Pinoccio/hardware-backpack-wifi/README.md

wifi-hardware-reference
===========================

Contained are the schematics, board layout, data sheets, and BOM for the Pinoccio WiFi board.

The board revisions are also marked as tags in the git repository, if you'd like to see a previous version.
