Pinoccio/hardware-backpack-wifi/changes.txt

------------------------------------------------------------------------
- v1.0 - 2013-08-15
------------------------------------------------------------------------
- Rename some components for assembly

------------------------------------------------------------------------
- v0.13 - 2013-07-30
------------------------------------------------------------------------
- Add 100k pull-up resistor to general storage flash chip-select
- Add 100k pull-up resistors to both flash chips /H and /W pins
- Add programming pads for GS1011 external flash for faster programming
- Move backpack bus from ATtiny13A PB0 to PB1 to take advantage of 
  PB1's external interrupt (INT0) support, for smaller codebase

------------------------------------------------------------------------
- v0.11 - 2013-06-28
------------------------------------------------------------------------
- Remove 150mA LDO regulator for storage components, directly from VBAT
- Add second 2MB flash storage for WiFi module OTA update and SSL support
- Add SPI connections to WiFi module, for later higher-speed transfer
- Tie WiFi module GPIO27 to D6 for triggering WiFi update
- Add ATtiny13A for Backpack-bus support 

------------------------------------------------------------------------
- v0.9 - 2012-12-28
------------------------------------------------------------------------
- Add 500mA LDO regulator for Wi-Fi shield, directly from VBAT
- Add 150mA LDO regulator for storage components, directly from VBAT
- Add 2MB flash storage for logging
- Move hole cutout down to match changes in base board layout
- Update header legends to map to base board header changes
- Tie LDO enable pins to 3v3 header
- Add 10uF/low ESR and 0.1uF to handle large spikes in µSD slot

------------------------------------------------------------------------
- v0.7 - 2012-11-08
------------------------------------------------------------------------
- Add larger 22uF cap to power supply rail
- Update header legends to map to base board header changes

------------------------------------------------------------------------
- v0.6 - 2012-10-03
------------------------------------------------------------------------
Initial release
