Pinoccio/hardware-backpack-wifi/pdf/pinoccio-wifi-brd.pdf

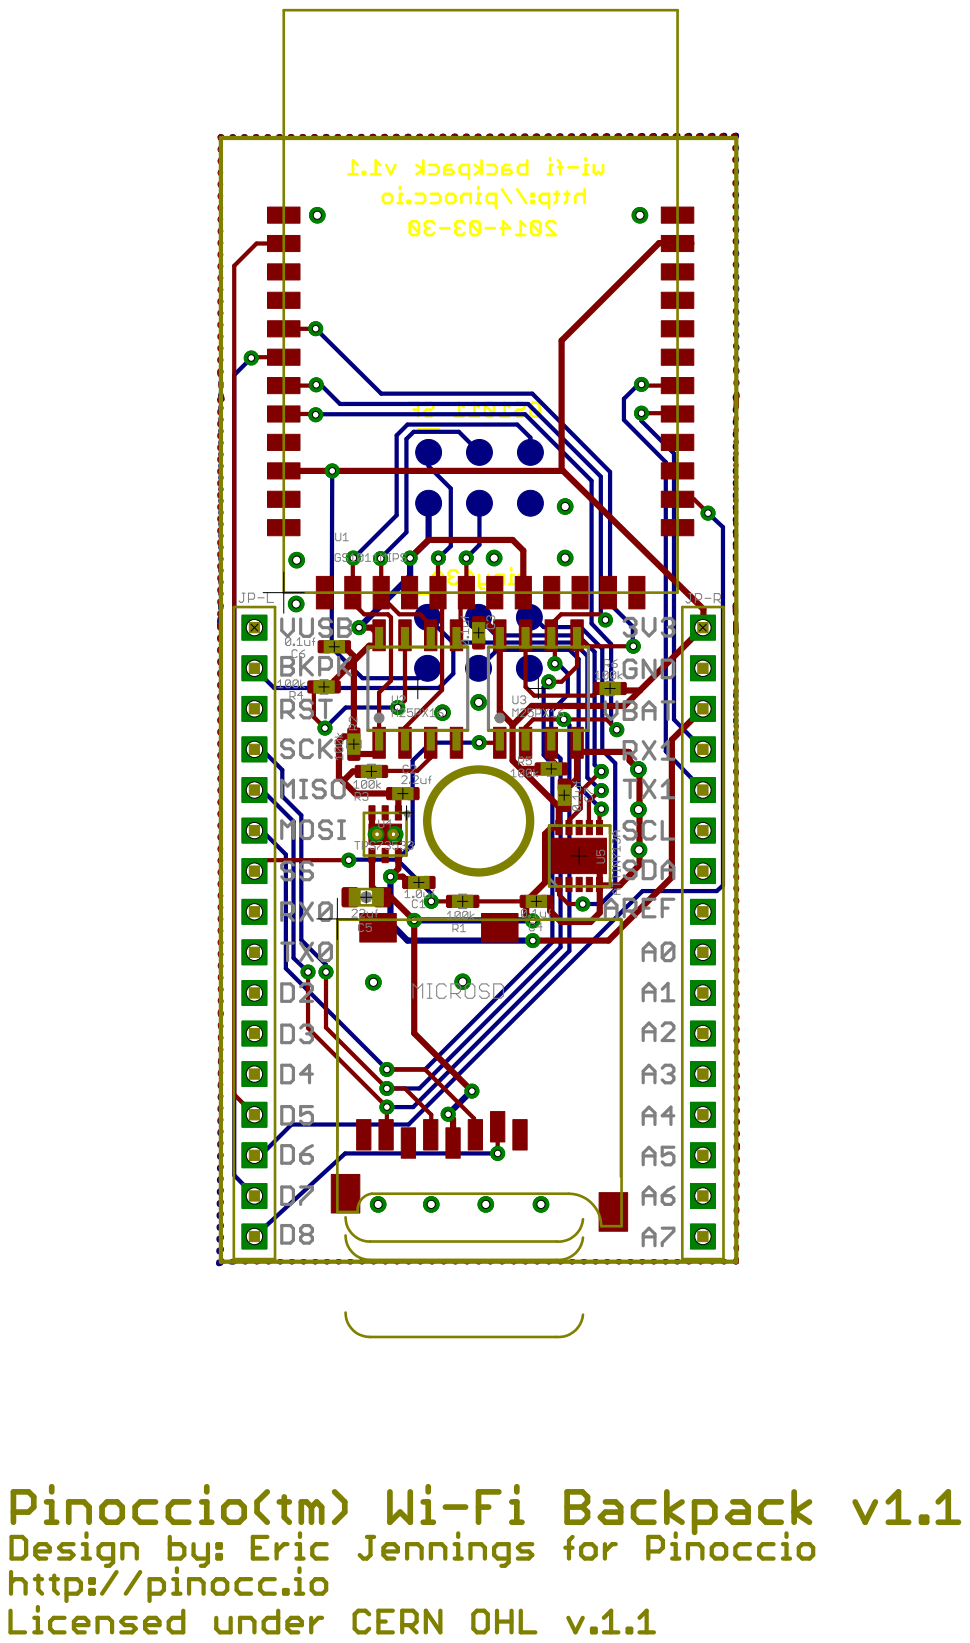
[picture p1: page 1]
