Pinoccio/hardware-backpack-wifi/pdf/pinoccio-wifi-sch.pdf

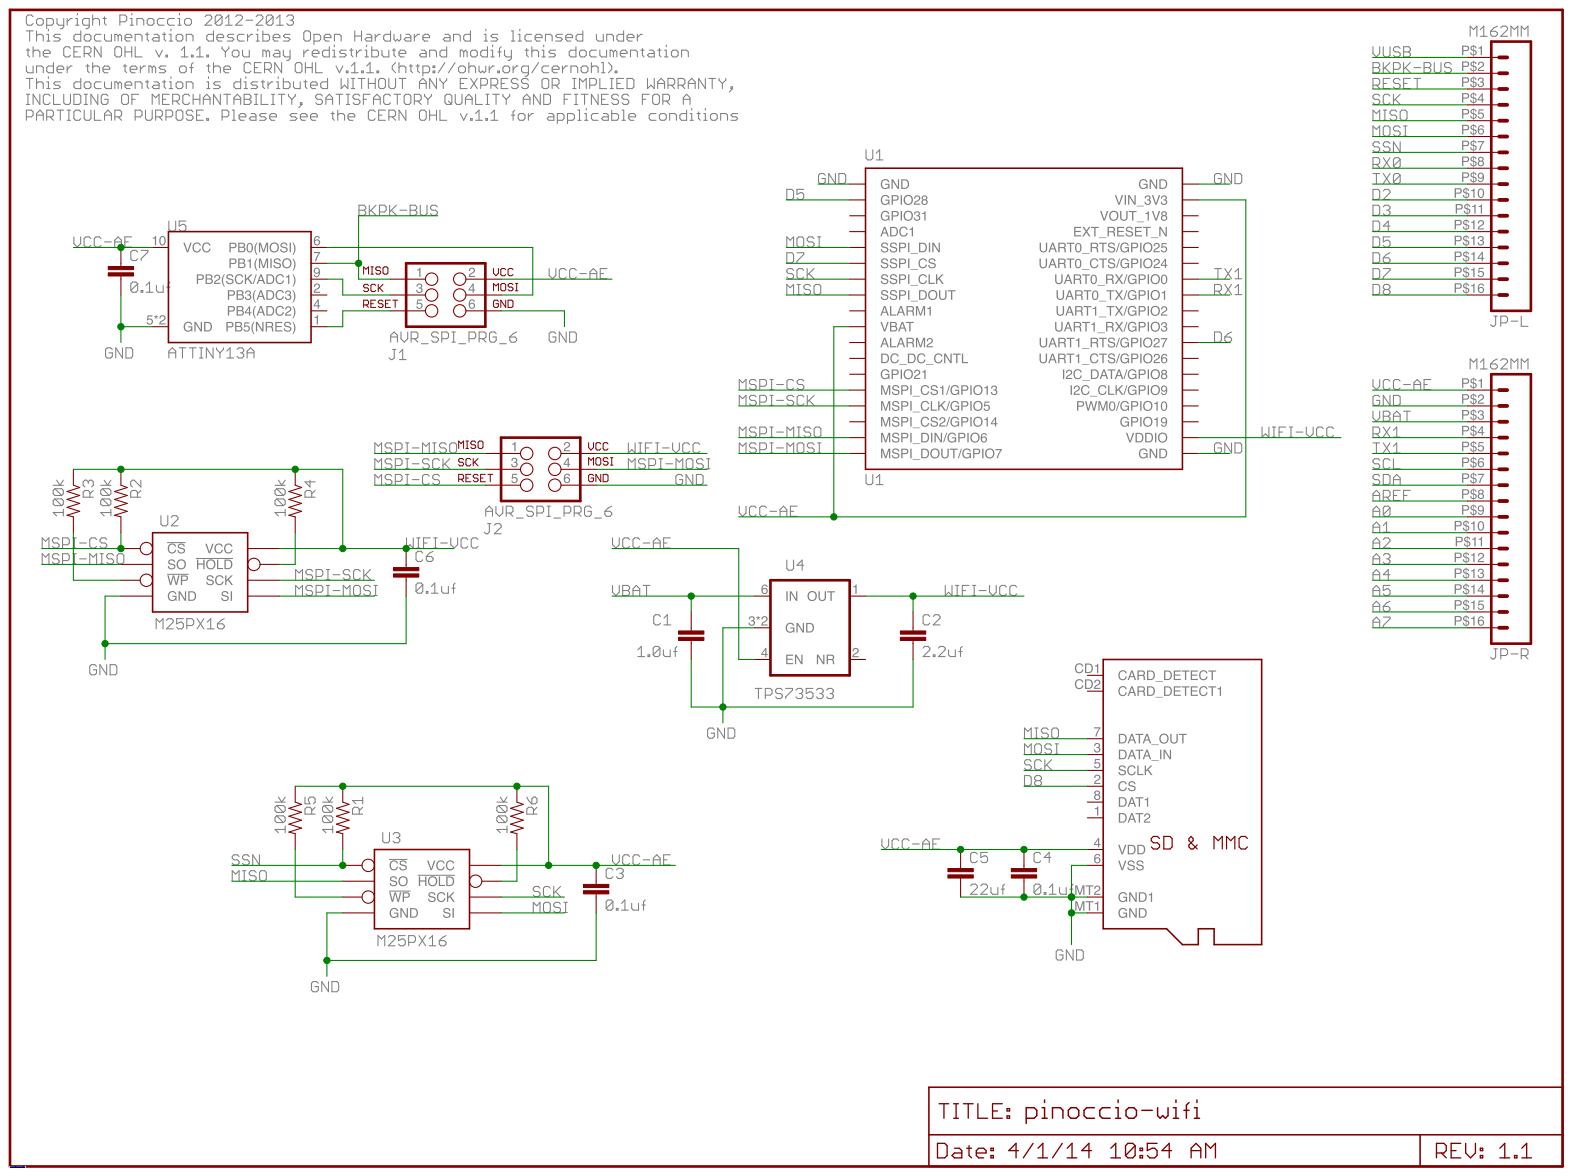
[picture p2: page 1]
