Pinoccio/hardware-backpack-wifi/pdf/v1.1/pinoccio-wifi-brd.pdf

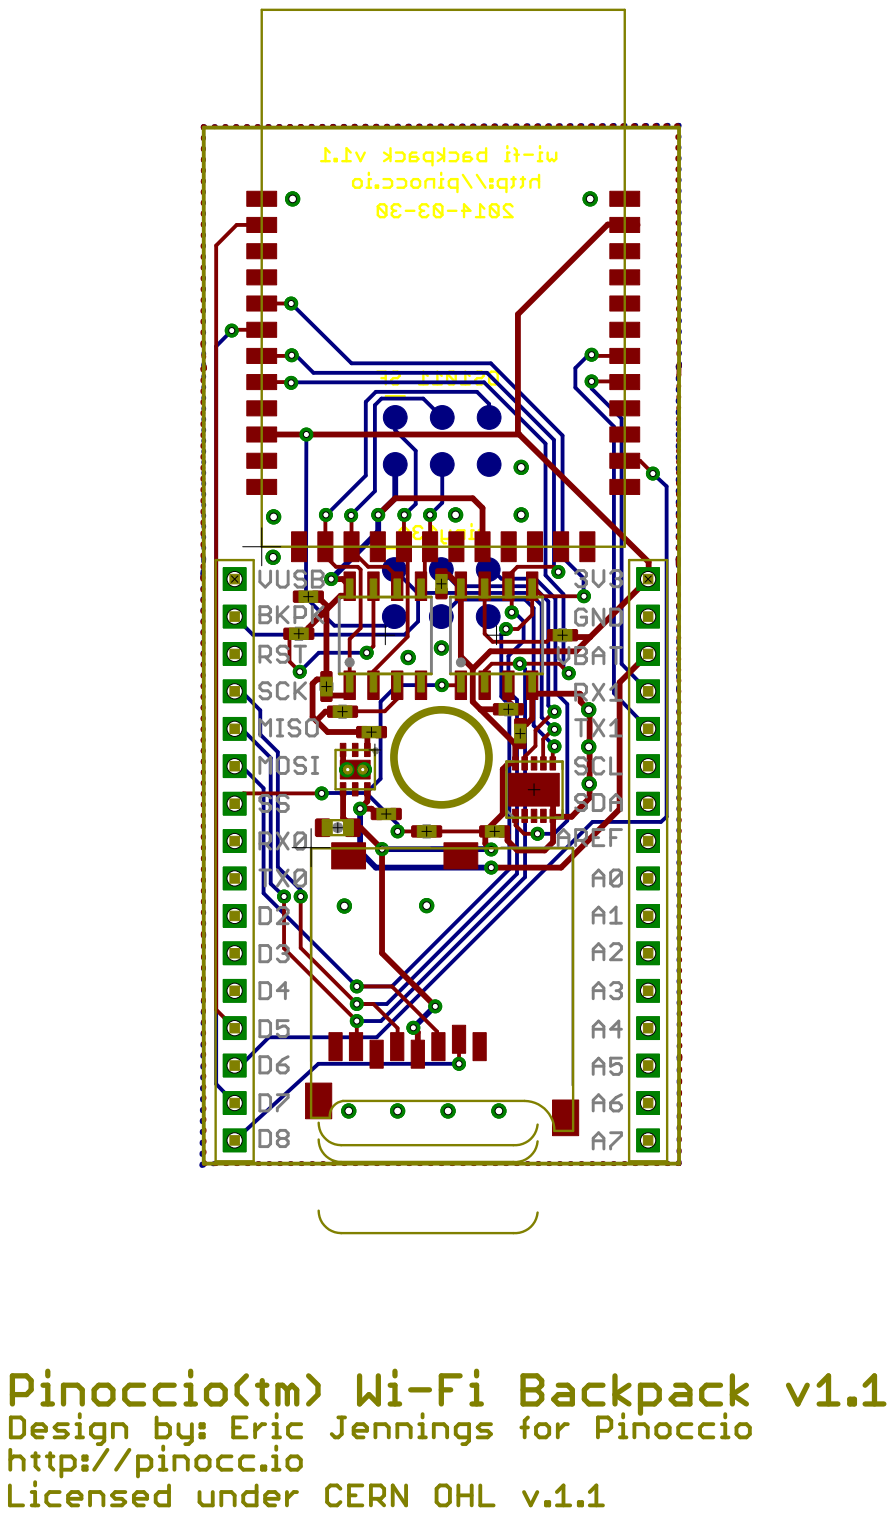
[picture p3: page 1]
