Pinoccio/hardware-backpack-wifi/eagle/pinoccio-wifi.brd

## EAGLE design eagle/pinoccio-wifi.brd (2014-06-27)

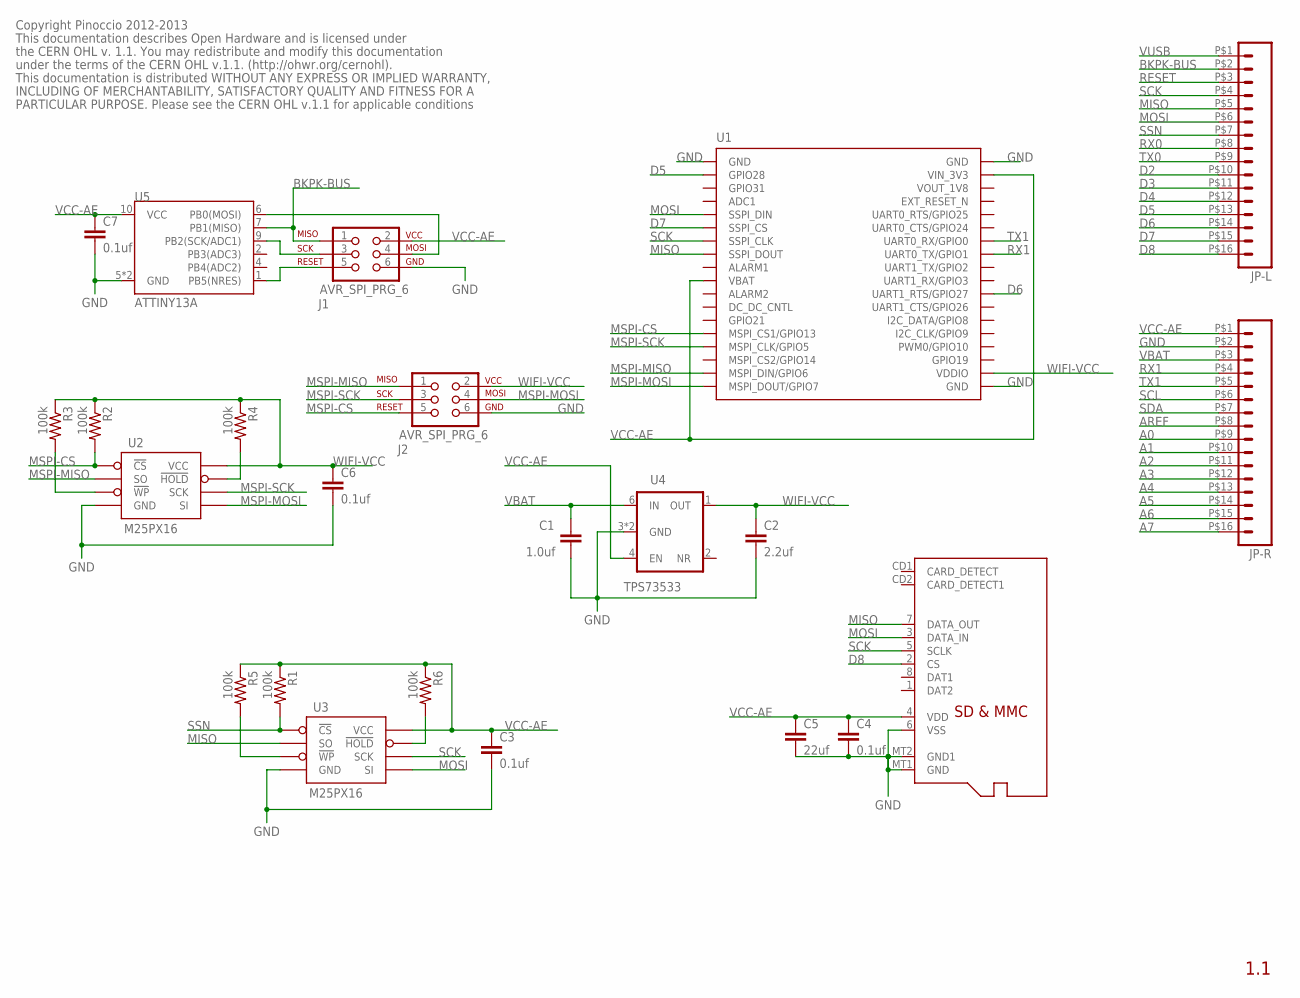
[picture p4: schematic pinoccio-wifi.sch]

Parts:
C1: 1.0uf; 0402-CAP
C2: 2.2uf; 0402-CAP
C3, C4, C6, C7: 0.1uf; 0402-CAP
C5: 22uf; 0603-CAP
J1, J2: AVR_SPI_PRG_6; 2X3-PAD
JP-L: M162MM; 1X16_2MM
JP-R: M162MM; 1X16_2MM
R1, R2, R3, R4, R5, R6: 100k; 0402-RES
U1: GS1011MIPS
U2, U3: M25PX16; SO8N
U4: TPS73533; SON-6-DRV
U5: ATTINY13A; QFN-10
U$1: MICROSD

Connections:
A0: JP-R.P$9 (9)
A1: JP-R.P$10 (10)
A2: JP-R.P$11 (11)
A3: JP-R.P$12 (12)
A4: JP-R.P$13 (13)
A5: JP-R.P$14 (14)
A6: JP-R.P$15 (15)
A7: JP-R.P$16 (16)
AREF: JP-R.P$8 (8)
BKPK-BUS: J1.1, JP-L.P$2 (2), U5.7 (PB1(MISO))
D2: JP-L.P$10 (10)
D3: JP-L.P$11 (11)
D4: JP-L.P$12 (12)
D5: JP-L.P$13 (13), U1.P$2 (GPIO28)
D6: JP-L.P$14 (14), U1.P$26 (UART1_RTS/GPIO27)
D7: JP-L.P$15 (15), U1.P$6 (SSPI_CS)
D8: JP-L.P$16 (16), U$1.2 (CS)
GND: C1.2, C2.2, C3.2, C4.2, C5.2, C6.2, C7.2, J1.6, J2.6, JP-R.P$2 (2), U1.P$1 (GND), U1.P$19 (GND), U1.P$36 (GND), U2.4 (GND), U3.4 (GND), U4.3 (GND), U4.PAD (GND), U5.5 (GND), U5.EP (GND), U$1.6 (VSS), U$1.MT1 (GND), U$1.MT2 (GND1)
MISO: JP-L.P$5 (5), U1.P$8 (SSPI_DOUT), U3.2 (SO), U$1.7 (DATA_OUT)
MOSI: JP-L.P$6 (6), U1.P$5 (SSPI_DIN), U3.5 (SI), U$1.3 (DATA_IN)
MSPI-CS: J2.5, R2.2, U1.P$14 (MSPI_CS1/GPIO13), U2.1 (!CS)
MSPI-MISO: J2.1, U1.P$17 (MSPI_DIN/GPIO6), U2.2 (SO)
MSPI-MOSI: J2.4, U1.P$18 (MSPI_DOUT/GPIO7), U2.5 (SI)
MSPI-SCK: J2.3, U1.P$15 (MSPI_CLK/GPIO5), U2.6 (SCK)
unnamed: R3.2, U2.3 (!WP)
unnamed: J1.4, U5.6 (PB0(MOSI))
unnamed: J1.3, U5.9 (PB2(SCK/ADC1))
unnamed: J1.5, U5.1 (PB5(NRES))
unnamed: R4.2, U2.7 (!HOLD)
unnamed: R6.2, U3.7 (!HOLD)
unnamed: R5.2, U3.3 (!WP)
RESET: JP-L.P$3 (3)
RX0: JP-L.P$8 (8)
RX1: JP-R.P$4 (4), U1.P$29 (UART0_TX/GPIO1)
SCK: JP-L.P$4 (4), U1.P$7 (SSPI_CLK), U3.6 (SCK), U$1.5 (SCLK)
SCL: JP-R.P$6 (6)
SDA: JP-R.P$7 (7)
SSN: JP-L.P$7 (7), R1.2, U3.1 (!CS)
TX0: JP-L.P$9 (9)
TX1: JP-R.P$5 (5), U1.P$30 (UART0_RX/GPIO0)
VBAT: C1.1, JP-R.P$3 (3), U4.6 (IN)
VCC-AE: C3.1, C4.1, C5.1, C7.1, J1.2, JP-R.P$1 (1), R1.1, R5.1, R6.1, U1.P$10 (VBAT), U1.P$35 (VIN_3V3), U3.8 (VCC), U4.4 (EN), U5.10 (VCC), U$1.4 (VDD)
VUSB: JP-L.P$1 (1)
WIFI-VCC: C2.1, C6.1, J2.2, R2.1, R3.1, R4.1, U1.P$20 (VDDIO), U2.8 (VCC), U4.1 (OUT)

Notes on the sheet:
1.1
Copyright Pinoccio 2012-2013
This documentation describes Open Hardware and is licensed under
the CERN OHL v. 1.1. You may redistribute and modify this documentation
under the terms of the CERN OHL v.1.1. (http://ohwr.org/cernohl).
This documentation is distributed WITHOUT ANY EXPRESS OR IMPLIED WARRANTY,
INCLUDING OF MERCHANTABILITY, SATISFACTORY QUALITY AND FITNESS FOR A
PARTICULAR PURPOSE. Please see the CERN OHL v.1.1 for applicable conditions

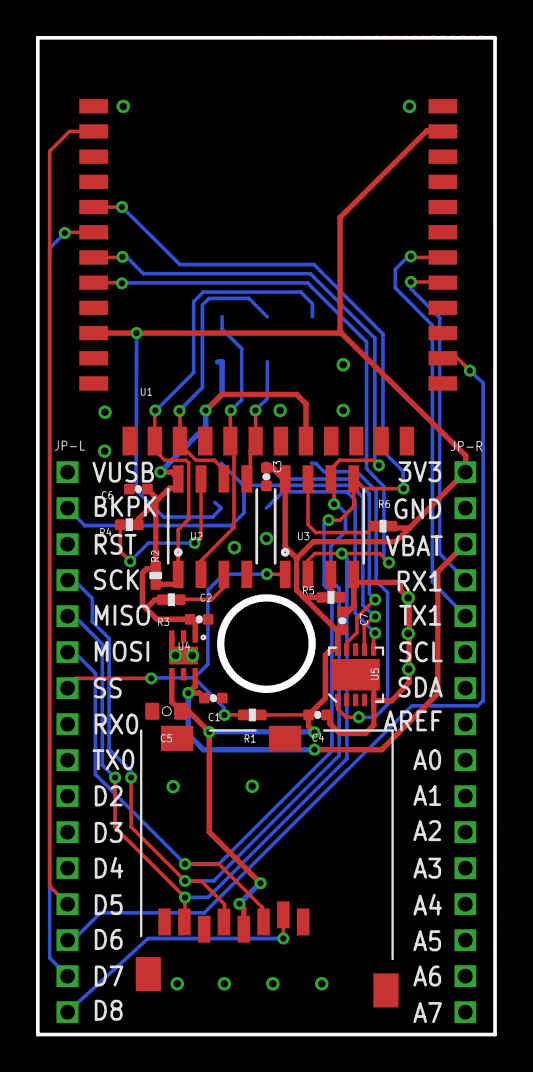
[picture p5: board pinoccio-wifi.brd from above]

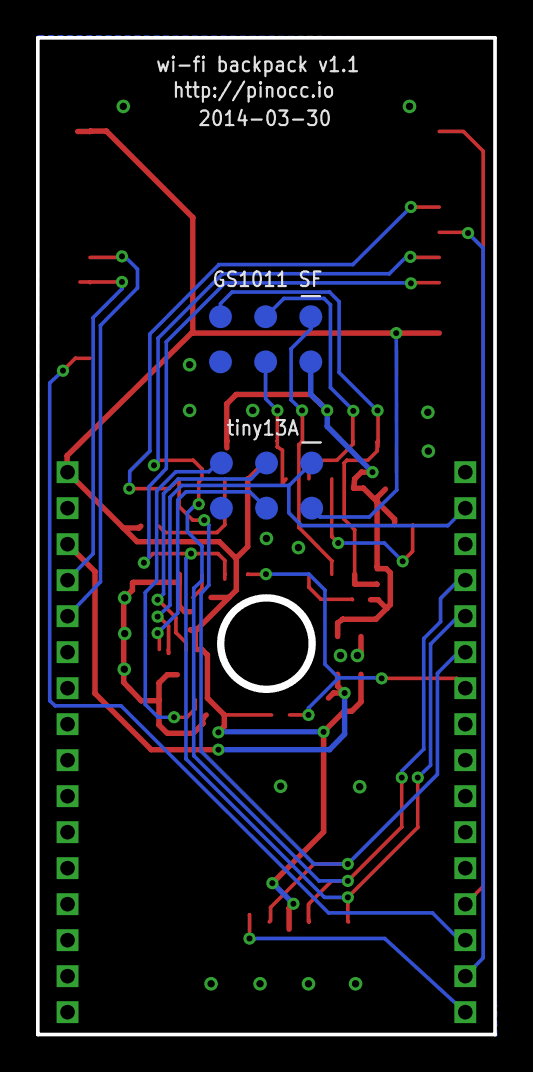
[picture p6: board pinoccio-wifi.brd from below]

Board: 2 copper layers, 25.4 x 55.4 mm, 23 parts (2 on the bottom side), 26 nets.
