Pinoccio/hardware-backpack-wifi/(commit log)

2013-12-11 Initial import
    [pinoccio-wifi.brd, pinoccio-wifi.sch]
2013-12-11 More fixups to capacitor design error and lack of enable
    [pinoccio-wifi.brd, pinoccio-wifi.sch]
2013-12-11 Revision v0.9
    [pinoccio-wifi.brd, pinoccio-wifi.sch]
2013-12-11 Moar fixups
    [pinoccio-wifi.brd, pinoccio-wifi.sch]
2013-12-11 Update datasheet and dioide layout to 0603
    [pinoccio-wifi.brd, pinoccio-wifi.sch]
2013-12-11 v0.11 changes
    [pinoccio-wifi.brd, pinoccio-wifi.sch]
2013-12-11 v0.11 datasheets
    [pinoccio-wifi-module.brd, pinoccio-wifi-module.sch]
2013-12-11 removed incorrect boards
    [pinoccio-wifi-module.brd, pinoccio-wifi-module.sch]
2013-12-11 Updated board to v0.13
    [pinoccio-wifi.brd, pinoccio-wifi.sch]
2013-12-11 update wifi to v0.13
    [pinoccio-wifi.brd, pinoccio-wifi.sch]
2013-12-11 add PDFs of schems/board
2013-12-11 updated names of components for assembly
    [pinoccio-wifi.brd, pinoccio-wifi.sch]
2013-12-11 Fix #1: typo for VUSB
    [pinoccio-wifi.brd, pinoccio-wifi.sch]
2014-03-30 Add v1.1 changes
    [pinoccio-wifi.brd, pinoccio-wifi.sch]
2014-03-30 Add data-ready trace to D5
    [pinoccio-wifi.brd, pinoccio-wifi.sch]
2014-04-01 Removed labels, updated build date
    [pinoccio-wifi.brd]
2014-06-27 Show component names and values on the PCB
    [pinoccio-wifi.brd, pinoccio-wifi.sch]
2014-06-27 Update eeprom.yaml for v1.1
    This bumps the version number and adds the "rdy" pin, which connects to
    the SPI data ready pin on the GS1011.
2014-07-03 Add bom
