Pinoccio/hardware-backpack-wifi/(notices)

Notices in the files:
eagle/pinoccio-wifi.brd:
Licensed under CERN OHL v.1.1
